aru-pat/C-UAS-Turret/README.md

# C-UAS-Turret

A pan-tilt turret that detects and tracks a drone with a self-trained neural
network and fires a low-power laser lock-on indicator. Semester 1: ground-based
turret detecting and tracking drones; semester 2: mount the system on a drone
platform.

Docs (in `docs/`):
- `project-reqs.md` — what the project must do, hardware split, budget
- `prototype-reqs.md` — checklists for Prototypes 1, 2 and 3
- `gantt.md` — timeline by availability window and key dates
- `design-decisions.md` — every design decision and why I made it
- `s42c-bringup-tests.md` — bench test results and the pin/voltage table for the PCB
- `turret_bom.xlsx` — parts list with links, prices, and decide-by / order-by dates
