aru-pat/C-UAS-Turret/gantt.md

# Timeline — by availability window

| Window | Dates | Load | Work |
|---|---|---|---|
| A | Oct 16 – Nov 2 | Full | Prototype 1 (breadboard motors + hand-detection model + finalize/order custom PCB) |
| B | Nov 2 – Nov 20 | Exams, near-zero | No build work. PCB fab ships passively. |
| C | Nov 20 – Dec 7 | Full (incl. Thanksgiving) | Checkpoint → Prototype 2 → Prototype 3 |
| D | Dec 7 – Dec 11 | Finals, near-zero | Demo video + writeup only. No new builds. |

Split: ~35% effort in A, ~35% in C, ~15% C-tail, ~15% D.

**Checkpoint:** start of Window C. Decide continue vs. simplify based on Prototype 1 results.
