aru-pat/C-UAS-Turret/docs/gantt.md

# Timeline — by availability window

Last updated: Oct 29, 2026

| Window | Dates | Load | Work |
|---|---|---|---|
| A | Oct 16 – Nov 2 | Full | Prototype 1 (breadboard motors + drone-detection model + laser) and design/order the custom PCB |
| B | Nov 2 – Nov 20 | Exams, near-zero | No build work. PCB fab ships passively. Order Pi parts by Nov 10. |
| C | Nov 20 – Dec 7 | Full (incl. Thanksgiving) | Checkpoint → Prototype 2 → Prototype 3 |
| D | Dec 7 – Dec 11 | Finals, near-zero | Demo video + writeup only. No new builds. |

Split: ~35% effort in A, ~35% in C, ~15% C-tail, ~15% D.

**Checkpoint:** start of Window C. Decide continue vs. simplify based on Prototype 1 results.

## Key dates (conservative; the BOM has the per-part version)

| Date | What |
|---|---|
| Sat Oct 17 night / Mon Oct 19 | Order motor kits and USB camera (the ECE shop won't have them). Mon Oct 19: check the ECE shop, then place the Amazon and Digi-Key orders; buy fuse parts locally |
| Oct 20 | Last day to order the cheap AliExpress 5 V module if I want to test it before the PCB order |
| Oct 24 | Decide the 5 V module (and have the power connector settled) so PCB layout can start; CAD target done |
| Oct 26 | Motor checkpoint (the ESP32 fallback date was dropped on Oct 26). Bench tests of the S42C kits passed Oct 25-28; Nucleo driving a motor is still to do. Screws ordered by this date |
| Oct 30 | **Target** PCB fab order + connectors/passives order |
| Nov 1 | **Hard limit** for the PCB order (exams start Nov 2) |
| Nov 10 | Order Pi 5 8 GB, power supply, cooler, microSD |
| Nov 20 | Window C starts: Prototype 2 |
| Nov 22 / 24 | Decide / order the battery, only if building one (must arrive before Dec 1) |
| Nov 23 | Decide the Coral after measuring the Pi alone |
| Dec 7 | Prototype 3 done; Window D (finals) |
| Dec 12 | Demo-ready |
