aru-pat/C-UAS-Turret/docs/turret_bom.xlsx

Sheet: BOM
Counter-UAS Turret - Bill of Materials (one row per part)
Updated 2026-10-19. Status: Verified = I opened the live page and saw this price/stock. Needs check = price seen in a search result or unconfirmed detail. Estimate = my guess, no listing. Blue = typed-in input. Qty 0 = not counted in totals. Shipping and tax NOT included.
ORANGE rows = ECE SHOP LOANS: I must RETURN them (see the Return to ECE Shop tab). PURPLE rows = from my 2k7 lab kit (free, mine). Both cost $0 here.
# | Subsystem | Part name | Specific component | Qty | Prototype | Status | Unit price ($) | Ext. price ($) | Vendor | Link | Est. arrival | Why I chose it | CAD footprint | KiCad footprint | Notes / watch-outs | Decide by | Order by
PROTOTYPE 1 - order now (breadboard motors + trained model + laser)
1 | Control | Microcontroller dev board: NUCLEO-G474RE (OPTIONAL, not counted) | STMicroelectronics NUCLEO-G474RE (Nucleo-64, STM32G474RE) | 0 | P1 | Verified | $20.13 | $0.00 | Digi-Key | Link (https://www.digikey.com/en/products/detail/stmicroelectronics/NUCLEO-G474RE/10231585) | Digi-Key. Shipping time not shown on the page; confirm at checkout. | I wanted the motor brain to be the one the industry or resume people will like better, so STM32 instead of ESP32, with one condition: it must cost only about 5 extra hours, because time is my tightest limit (10-12 hrs/week). We used Arduino-style code (PlatformIO) to hold it to that. The Nucleo-G474RE is a chip plus a built-in USB programmer on one board, so I can start testing motors right away. The G474 was chosen because the G431RB is out of stock with a 99-week lead time. Escape hatch: if no motor is turning by Oct 26, I switch to an ESP32-S3. I also chose to make my custom PCB a carrier board that this Nucleo plugs into, so this board stays in the finished turret. |  |  | Seen in stock (1,981) on digikey.com. Its '99 weeks' is the restock lead time, not your wait. Amazon sellers charge $88-349, do not buy there. Ask the Purdue ECE shop first; if they have a Nucleo board, skip this. 2026-10-19: the ECE shop loaned me a Nucleo-144 (row below), so I can start motor tests now. That board goes back, so if the shop wants it back before Dec 12, I buy this one. Not counted because I already have a Nucleo. | Only if I need my own Nucleo | Only if needed (Digi-Key, 2-3 days)
2 | Control | Nucleo-144 dev board (ECE shop LOAN) | STM32 Nucleo-144 with the STM32F746ZG chip, in its black case (the shop's other board was an F413ZH) | 1 | P1 | Free: ECE shop (RETURN) | $0.00 | $0.00 | ECE shop (RETURN) |  | n/a | The shop only had two Nucleo-144 boards. I picked the F746ZG over the F413ZH because it is faster (216 MHz vs 100 MHz) and more people use it, so there are more tutorials. It is free and I have it today, so I can start the motor tests now instead of waiting for a board to ship. It is a loan, so it goes back to the ECE shop. |  |  | RETURN to the ECE shop. In the code project, pick the STM32F746ZG (not the G474 or the H723; the shop catalog's link for it was wrong). The programming port looks like Micro-B in the photo, which matches the Micro-B cable I got. A Nucleo-144 does not plug into a carrier made for the smaller Nucleo-64, so use jumper wires for P1. | Done Oct 19 | Not buying (loan). Return it to the ECE shop.
3 | Motion | Closed-loop motor + driver kit (pan + tilt) | BIGTREETECH S42C V1.1 + metal cover + motor kit (Octobigtree) | 2 | P1 | Verified | $39.99 | $79.98 | Amazon | Link (https://www.amazon.com/dp/B09LHFS2HF) | Listing showed delivery Sun Oct 18 on your screen. | Closed-loop motors were in the original spec: backlash and lost steps were named as a top failure risk, and a turret has to turn fast to track a moving target without losing its aim. I need motors soon so I can start the CAD, the breadboard wiring and model training, so the pick had to arrive in days. The BTT S42C kit includes the motor, the driver and the position sensor, so there is nothing to match up, costs $39.99 each, and Amazon showed delivery Oct 18. Plain steppers with separate drivers (about $50 for two axes) were rejected as open-loop. I chose 12 V for the motor rail because a 12 V battery is much cheaper than a 24 V one, and my rule was: if it is not that much slower, go 12 V. The 24 V hedge came from my worry that a turret must move fast: the PCB parts are rated for 24 V so I can upgrade later without a new board. |  |  | Motor is included per the listing title ('S42C V1.1 + Metal Protective Cover + Motor'). Listing parameters image (checked Oct 19): motor supply 12-24 V, max current 1650 mA at 12 V, no-load 620 mA at 12 V, Step/Dir input, 14-bit encoder, 2000 rpm max, STM32G031. Two motors can pull about 3.3 A together at max, so set each motor's current near 1 A on the 3 A loan adapter. Power it first at 12 V with about a 1 A current limit. Motor torque is not stated, and the V1.0 manual pinout may differ from V1.1, so read the labels printed on the board. Check the Amazon delivery address is Purdue, not Palo Alto. 30-day free returns if a unit is dead (some reviewers report dead units). | Decided | Sat Oct 17 night or Mon Oct 19 at the latest (ECE will not have these; critical path for the Oct 26 test)
4 | Laser | Laser module (lock-on indicator) | WOWOONE 10-pack 650 nm 5 mW red dot laser modules, 5 V, 6 mm brass body, pre-wired (Amazon B0GSQTBGJM) | 1 | P1 | Verified | $6.69 | $6.69 | Amazon | Link (https://www.amazon.com/dp/B0GSQTBGJM) | Prime, free delivery Wed Oct 21 if ordered Oct 19 (Amazon showed this on the listing). Check the date at checkout. | I want the laser in Prototype 1 because I want to see the result of it firing when the model detects. I first picked a Walmart 4-pack, but it would not arrive in time, so I switched to this Amazon 10-pack ($6.69, arrives Wed Oct 21). I chose 5 mW over 1 mW because a 1 mW dot is barely visible, and the dot has to be seen in the demo. 10 modules means spares while I test the wiring. |  |  | 5 mW = Class 3R. Uses 5 V and about 20 mA, with a resistor built in, so no extra parts. Turn the barrel to focus the dot at the real distance. Best on a white target board in a dim room, 2-5 m away. Never aim at people, pets or shiny surfaces, never look into it. Some units in a pack are dim or poorly focused; test them all. Do not call it Class 2. | Decided | Mon Oct 19 for Wed Oct 21 delivery
5 | Laser | Laser switch (transistor) | Logic-level N-channel MOSFET: IRLU024N from the ECE shop (2 transistors in the bag; one is a small 3-leg TO-92 part, probably a 2N7000 or 2N2222A, so read the print). Backup: the RFD3055LE logic-level MOSFET in the 2k7 kit. | 2 | P1 | Free: ECE shop (RETURN) | $0.00 | $0.00 | ECE shop (RETURN) + 2k7 kit |  | Digi-Key. Shipping time not shown on the page; confirm at checkout. | An STM32 pin is too weak to power the laser by itself, so this small electronic switch lets the pin turn the laser on and off. The ECE shop gave me the part and my 2k7 kit has a second logic-level MOSFET, so I do not need to buy the $1.80 Digi-Key ones. |  |  | Replaces the 2 x $1.80 Digi-Key order. The laser only draws about 40 mA, so any of these parts works. Ask the desk whether the shop wants small parts like this back. | Done Oct 19 | Not buying (free)
6 | Vision | USB camera (final camera) | Arducam 1080p HDR autofocus USB camera module, 78 deg diagonal, metal body (ASIN B0FX47YSJQ) | 1 | P1 | Verified | $19.99 | $19.99 | Amazon | Link (https://www.amazon.com/dp/B0FX47YSJQ) | Page showed free delivery Mon Oct 19 (order within ~8 hours of Oct 17 evening). | My two reasons: (1) I want the model trained on the same camera the turret will actually use, because a different camera changes the picture quality and hurts training; (2) the camera mount in my CAD depends on the camera's exact size, so choosing the final camera now means I do not redo the CAD. I do NOT want to buy the Pi now, and the Pi camera only works on a Pi, so I needed a camera that plugs into both my laptop and the Pi later: a USB camera. I set a $27 ceiling and picked this Arducam for autofocus, a narrower 78-degree view, a 1 m cable in the box and a small metal body I can unscrew from its stand and mount in a printed holder. I accepted a cheaper picture than the $39-65 cameras and may upgrade once I am committed. |  |  | You plan to unscrew it from its stand and mount just the case. When it arrives, check MJPG 1920x1080 at 30 fps is listed (v4l2-ctl --list-formats-ext on Linux, or OBS on your laptop); return it if not. Includes a 1 m USB cable with a JST connector. Only 22 ratings, 4.0 stars (100+ bought last month). The page does not list MJPEG, cable length, size or weight: get the dimensions before finishing the camera mount in CAD. Cheaper picture quality than the $39-65 cameras. Fallbacks: Arducam IMX219 autofocus $38.99 (B09BR1RNSN), ELP IMX362 $64.99 (B0DQNP1MP9). | Decided | Sat Oct 17 night for Mon delivery, or Mon Oct 19 at the latest (does not depend on the ECE shop)
7 | Power | 12 V 5 A wall adapter (BACKUP, not counted) | Facmogu 12 V 5 A, 60 W AC-DC adapter (ASIN B0711Q5B49) | 0 | P1 | Needs check | $11.99 | $0.00 | Amazon | Link (https://www.amazon.com/dp/B0711Q5B49) | Not seen. Check the listing. | I asked whether the turret could run from a simple laptop charger for now and do the battery later, because the battery set was expensive and I cannot spend $300 in one month. A 12 V 5 A wall adapter is the cheap answer: 12 V is the motor voltage I picked, and 5 A (60 W) covers the estimated peak of about 87 W with some margin. The ECE shop may have one for free, so I will check Monday before buying. |  |  | Not counted while I use the shop's Neewer 12 V 3 A loan. Buy this if the shop needs the Neewer back before Dec 12, or if 3 A keeps shutting off. Check the plug is 5.5x2.1 mm before ordering. Check the plug is 5.5x2.1 mm (the title does not say). The ECE shop may have a 12 V supply you can use. | Nov 15 (only if the shop wants the Neewer back before the demo, or 3 A is too small) | Nov 20 at the latest, only if needed (Amazon, 2 days)
8 | Power | 12 V 3 A wall adapter (ECE shop LOAN) | NEEWER NW-120300D2 power supply: 100-240 V AC in, 12 V DC 3.0 A out, barrel plug, UL listed | 1 | P1 | Free: ECE shop (RETURN) | $0.00 | $0.00 | ECE shop (RETURN) |  | n/a | It powers the two motors for P1. 12 V is the motor voltage I picked, and 3 A is enough while I set each motor's current to about 1 A. It is a free loan from the ECE shop, so I do not pay the $11.99 for the 5 A adapter yet. |  |  | RETURN to the ECE shop. The label says output 12 V DC (the AC on the label is the wall side). 3 A is near the limit: two motors can pull about 3.3 A if both stall, so keep each motor's current setting near 1 A. Before connecting: check the plug is 5.5x2.1 mm with the center pin positive (+), and measure about 12 V DC at the plug. The first motor power-up should still use a bench supply set to 12 V with about a 1 A limit, if I can borrow one. | Done Oct 19 | Not buying (loan). Return it to the ECE shop.
9 | Power | Barrel jack to screw terminals | 2.1 x 5.5 mm female DC power jack to screw terminal connector, from the 2k7 kit (kit part ELCONN-DCP.ST-M-03) | 1 | P1 | Free: 2k7 kit | $0.00 | $0.00 | 2k7 kit |  | n/a | Lets me plug the wall adapter in and get two plain wires (+ and -) for the breadboard. My 2k7 lab kit already comes with one, so I do not need the $6.99 Amazon 20-pack. |  |  | Replaces the Amazon 20-pack. Check the loan adapter's plug really is 5.5 x 2.1 mm (it fits this jack if so). | Done Oct 19 | Not buying (free)
10 | Power | Fuse holder | Inline ATC (regular size) blade fuse holder, rated 15 A or more. Reference part: Bussmann #12, Hemlock SKU 580112 | 1 | P1 | Estimate | $5.00 | $5.00 | Auto parts store / ECE shop (Hemlock = fallback) | Link (https://hemlockhardware.com/products/580112-bussmann-20-amp-12-atc-inline-blade-fuse-holder) | Same day at a local store (not checked). Hemlock fallback: in stock, 1-2 day delivery. | I asked what a fuse is and why I need it: it is a cheap part that melts on a short circuit and cuts power before wires get hot, and the holder lets me replace it. I chose to skip the online store (Hemlock) because of its shipping cost and to buy at an auto parts store or get it from the ECE shop. Must be a regular ATC size, rated 15 A or more. |  |  | Skip Hemlock (shipping). Buy at AutoZone/O'Reilly or ask the ECE shop. Must be regular ATC size (not Mini/Micro), 15 A or more, with thick wire. Price is a guess. | Oct 19 (after ECE shop check) | Mon Oct 19 (local store, same day)
11 | Power | Fuse | 15 A regular-size ATC blade fuses, multi-pack. Reference part: Bussmann 4-pack, Hemlock SKU 573597 | 1 | P1 | Estimate | $6.00 | $6.00 | Auto parts store / ECE shop (Hemlock = fallback) | Link (https://hemlockhardware.com/products/573597-bussmann-15-amp-32-volt-atc-blade-automotive-fuse-4-pack) | Same day at a local store (not checked). Hemlock fallback: in stock, 1-2 day delivery. | Same reasoning as the holder: protects the wiring in a short. 15 A is above the estimated 10 A peak so it will not blow during normal motor bursts. I will buy local or from the ECE shop to avoid shipping. |  |  | Buy spares. If it blows, find out why before replacing it. For P1 on the 3 A loan adapter, a 5 A fuse is enough. 15 A is the final-turret value. | Oct 19 (local store) | Mon Oct 19 (local store, same day)
12 | Power | Spike protector (TVS diode) | Littelfuse SMCJ15A, 15 V standoff, DO-214AB | 1 | P1 | Needs check | $0.99 | $0.99 | Digi-Key | Link (https://www.digikey.com/en/products/detail/littelfuse-inc/SMCJ15A/762382) | Digi-Key. Shipping time not shown on the page; confirm at checkout. | Motors switching on and off create brief voltage spikes far above 12 V, and this part clamps them so they cannot hurt the drivers or the chip. It fits my 24 V upgrade hedge (I swap it for a higher-voltage version if I move to 24 V). It costs $0.99. |  |  | Use digikey.com, not the Australian site. Price/stock came from Grok, not confirmed by me (I confirmed the part and its 24.4 V clamp). If you move to 24 V later, swap this for a higher-voltage version. | Decided | Oct 30, in the same Digi-Key order as the PCB parts (a $0.99 part is not worth its own shipping)
13 | Power | Bulk capacitor | 100 uF 35 V electrolytic x2 from the 2k7 kit (kit part ELCAP-AE-35V-100U-05), used as a stand-in for the 1000 uF | 2 | P1 | Free: 2k7 kit | $0.00 | $0.00 | 2k7 kit |  | n/a | A small water tank for electricity that smooths the motors' power gulps. The ECE shop's 1000 uF capacitors are only rated 16 V, which is too low for a 12 V rail that can spike, so I use my kit's 100 uF 35 V ones for P1. |  |  | 100 uF is ten times smaller than my 1000 uF plan, which is fine for P1 on a current-limited supply because the S42C boards have their own capacitors. For the final turret, buy a 1000 uF 35 V capacitor (fallback: https://www.getfpv.com/black-xt60-lipo-pigtail-w-35v-1000uf-capacitor-12awg-3pcs.html, $10.99). Never use the shop's 16 V ones on the motor rail. | Done Oct 19 | Not buying (free)
14 | Wiring | Breadboard + jumper wires (2k7 kit) | EurekaLeap 3220 tie-point solderless breadboard with 4 binding posts + 350-piece 22 AWG jumper wire set (both from the 2k7 kit) | 1 | P1 | Free: 2k7 kit | $0.00 | $0.00 | 2k7 kit |  | n/a | My 2k7 lab kit comes with a big breadboard and a 350-piece jumper wire set, so I do not buy any. |  |  | The binding posts on the board are handy for the 12 V in and ground. | Done Oct 19 | Not buying (free)
15 | Wiring | Resistors (2k7 kit) | Resistor pack, 1/2 W 1%: 5 of most values, 10 each of 1, 100, 1k, 10k, 100k, 1M (includes 220 ohm and 10k ohm) | 1 | P1 | Free: 2k7 kit | $0.00 | $0.00 | 2k7 kit |  | n/a | The MOSFET needs a 220 ohm resistor on its gate and a 10k ohm resistor to hold it off. My kit has both, so I do not need the shop's. |  |  | Kit part RES-120-00100-EH. | Done Oct 19 | Not buying (free)
16 | Wiring | Male pin headers (ECE shop) | Standard single-row male pin header strips (from the shop's drawer 101) | 1 | P1 | Free: ECE shop (RETURN) | $0.00 | $0.00 | ECE shop (RETURN) |  | n/a | For connecting the motor driver boards and jumper wires to the breadboard. |  |  | Small parts. Ask the desk whether they want these back. | Done Oct 19 | Not buying (free)
17 | Wiring | Hand tools (2k7 kit) | Multi-purpose crimp / strip / cut tool (14-24 AWG), pocket 1/8 in screwdriver, banana-plug test leads, clamp | 1 | P1 | Free: 2k7 kit | $0.00 | $0.00 | 2k7 kit |  | n/a | The kit's tool strips and cuts wire, so I do not borrow wire strippers. The small screwdriver fits terminal screws. |  |  | Kit parts ELTOOL-WCS-YTH-5022-01, ELACC-TSCREWDRIVER-C-01, ELCAB-BNTPL-RB-36i-01. | Done Oct 19 | Not buying (free)
18 | Wiring | USB cable: USB-A to Micro-B (ECE shop LOAN) | USB data cable with a USB-A plug on one end and a Micro-B plug on the other (from my photos), black braided | 1 | P1 | Free: ECE shop (RETURN) | $0.00 | $0.00 | ECE shop (RETURN) |  | n/a | The Nucleo's programming port looks like Micro-B. The shop gave me a cable that matches it, so I do not need to buy one. |  |  | RETURN to the ECE shop. Test it: plug it into the Nucleo and my laptop. If the board lights up but the laptop sees nothing new, it is charge-only. It plugs straight into my laptop's USB-A port. | Done Oct 19 | Not buying (free)
19 | Wiring | USB cable: USB-A to USB-C (ECE shop LOAN) | USB cable with a USB-A plug and a USB-C plug, black braided (from my photos) | 1 | P1 | Free: ECE shop (RETURN) | $0.00 | $0.00 | ECE shop (RETURN) |  | n/a | A second cable from the shop. Free, so I keep it as a spare. |  |  | RETURN to the ECE shop. My laptop has both USB-A and USB-C ports, so this is just a spare. | Done Oct 19 | Not buying (free)
20 | Mechanical | Screws, standoffs, fasteners | M3 screw assortment (motor mounts are M3 on NEMA 17) plus whatever your CAD needs | 1 | P1 | Estimate | $15.00 | $15.00 | Amazon / hardware store |  | n/a | I have access to a 3D printer, so I print the pan-tilt frame and the camera holder, and I can only list exact screw sizes after the CAD is done. I do not own screws but can get them. This $15 is a placeholder. |  |  | Allowance only. Finish the CAD, then list exact screw sizes and lengths before buying. You can print the structure yourself. | After the CAD is done (target Oct 24) | By Oct 26 (must arrive before Nov 2)
21 | Test | Multimeter | Borrowed from a lab or a friend | 0 | P1 | Borrowed | $0.00 | $0.00 | n/a |  | n/a | To measure voltage and find shorts before connecting anything expensive. Borrowed. |  |  | Not in my Oct 19 photos, so I still need to borrow one. Bench supply: use a ~1 A current limit for the first motor power-up. The 2k7 kit has banana-plug test leads but no meter.
 |  | PROTOTYPE 1 TOTAL |  |  |  |  |  | $133.65
PCB - target order Oct 30, hard limit Nov 1 (exams start Nov 2; it ships during the dead zone). Parts depend on your design. Prices are estimates.
22 | PCB | DECISION (pinned): power input connector on PCB | Suggested: screw terminal (takes a wall adapter now, a battery later) | 0 | PCB | Open |  |  | n/a |  | n/a | I chose option D on Oct 17: a barrel jack AND an XT60 battery connector footprint, only one connected at a time. The wall adapter plugs into the barrel jack today and cannot go in backwards; a battery drops into the XT60 later with no redesign. A bare screw terminal was rejected because it can be wired backwards and loosen from vibration. The PCB is only ordered once, so the way power enters has to be right the first time. |  |  | Pinned. Discuss after the other open items. Not a purchase. | Oct 24 (so PCB layout can start) | n/a
23 | PCB | PCB fabrication | 5 boards, 2 layers, from JLCPCB or PCBWay (your design) | 1 | PCB | Estimate | $25.00 | $25.00 | JLCPCB / PCBWay |  | Target Oct 30; hard limit Nov 1. | I will not compromise on the custom PCB: it is the hardware half of my resume line. The board is a carrier board that the Nucleo plugs into, which I chose over a bare-chip board to cut risk (no fine-pitch chip soldering, no chip start-up problems) while keeping a real PCB design with real soldering. It must be ordered by Nov 1 at the latest (target Oct 30) so it ships during the exam dead zone. |  |  | Estimate includes shipping. Get a quote when the design is done. | Design finished Oct 30 | Target Oct 30; hard limit Nov 1 (exams start Nov 2)
24 | PCB | Microcontroller chip (OPTIONAL, not counted) | STM32G474 (package chosen in your design), same family as the Nucleo | 0 | PCB | Needs check | $10.70 | $0.00 | Digi-Key | Link (https://www.digikey.com/en/products/result?keywords=STM32G474RET6) | Order Oct 30 with the PCB. | Optional and not counted, my call. The Nucleo stays on the carrier board, so the bare chip is only needed if I later go chip-down. The price was found on a Digi-Key search result. |  |  | Optional for now: the PCB is a carrier board that the Nucleo plugs into, so the chip stays on the Nucleo. Only needed if you later go chip-down (your own chip on your own board). STM32G474RET6 (64-pin LQFP) was $10.70 on a Digi-Key search result; check stock if you do. | Only if going chip-down | Only if going chip-down (with the PCB order, buy 2)
25 | PCB | 5 V module for the Pi - OPTION A (counted) | Pololu D24V50F5, 5 V 5 A step-down regulator (item 2851) | 1 | PCB | Verified | $32.95 | $32.95 | Pololu | Link (https://www.pololu.com/product/2851) | 220 in stock (Oct 17). Order with the PCB. | The Pi needs a steady 5 V at about 5 A. I asked which design was more time-efficient and looked cleaner and more professional, and chose to have the PCB power the Pi, because I need the PCB by Prototype 2/3 anyway. A ready-made module that plugs into a socket means no regulator design. Option A is the known-good one from Pololu. I said to hold the choice for about a week (around Oct 24). |  |  | Known-good option. Needed for the final PCB (Prototype 3). In Prototype 2 the Pi runs on its wall supply instead. Option B below is cheaper but unproven. | Oct 24 (a week out); must be settled before layout | Oct 30, same time as the PCB order
26 | PCB | 5 V module for the Pi - OPTION B (not counted) | Generic 24V/12V to 5V 5A buck module, AliExpress (listing 3256809254781510) | 0 | PCB | Needs check | $5.24 | $0.00 | AliExpress | Link (https://www.aliexpress.us/item/3256809254781510.html) | Ships from China, likely 1-3 weeks (not checked). | A much cheaper alternative I found, kept as a second option. The seller's 5 A claim needs testing with a meter before it ever powers a Pi. I will decide between A and B in about a week. |  |  | The two options for the 5 V part are A (Pololu) and B (this). $5.24 normal price, 4.8 stars from only 58 reviews. The '5 A' claim is doubtful on this type of board; test with a meter and a dummy load before connecting a Pi. Footprint differs from Option A, so pick before the PCB layout is final. | Oct 24 | If you want to TEST it before the PCB order, buy by Oct 20 (ships 1-3 weeks). Ordered later, it arrives after the PCB is already sent.
27 | PCB | Connectors, passives, headers | Screw terminals, female headers for the Nucleo to plug into, resistors, capacitors for the PCB | 1 | PCB | Estimate | $15.00 | $15.00 | ECE shop / Digi-Key |  | Order Oct 30 with the PCB. | The small parts that finish the board. General items like these may be free from the Purdue ECE shop, so much of this may cost nothing. |  |  | Much of this may be free from the ECE shop. My 2k7 kit also has 1N5819 Schottky diodes (a possible reverse-polarity part) and spare resistors. | Oct 30 | Oct 30, same time as the PCB order (Digi-Key, 2-3 days)
 |  | PCB TOTAL |  |  |  |  |  | $72.95
PROTOTYPE 2 - order by Nov 10 (Pi wired to motors, live tracking)
28 | Vision | Raspberry Pi 5 (8 GB) | Raspberry Pi 5 8GB, board only (CanaKit SKU PI5-8GB) | 1 | P2 | Verified | $175.00 | $175.00 | CanaKit | Link (https://www.canakit.com/raspberry-pi-5-8gb.html) | In stock per the page; shipping time not checked. | I chose the 8 GB version and said I did not want the 4 GB: the RAM cannot be upgraded later, and the extra room helps with bigger models and the semester 2 drone work. I decided NOT to buy the Pi now; it is a Prototype 2 purchase, ordered by Nov 10. Training happens on my laptop or Colab, and the Pi only runs the finished model. |  |  | PiShop also lists $175. Adafruit lists $200. The 4 GB is $110 at CanaKit (not chosen). | Nov 6 | By Nov 10 (arrive before Nov 20)
29 | Vision | Pi power supply | RasTech 27 W GaN USB-C PD supply, 5.1 V 5 A for Raspberry Pi 5 (ASIN B0CLV6WB4L) | 1 | P2 | Needs check | $12.34 | $12.34 | Amazon | Link (https://www.amazon.com/dp/B0CLV6WB4L) | Not seen. Check the listing. | In Prototype 2 the Pi runs from its own wall supply so a bug in the brand-new PCB cannot ruin the checkpoint. The Pi wants 5 V at 5 A; a weaker charger can make it crash. |  |  | Official Pi 27 W supply is $22.91 on Amazon if you want the safest option. Check reviews for 5 A output. | Nov 6 | By Nov 10, same CanaKit order
30 | Vision | Pi cooler | Raspberry Pi 5 Active Cooler (CanaKit SKU RSP-ACTIVE-COOLER) | 1 | P2 | Verified | $11.95 | $11.95 | CanaKit | Link (https://www.canakit.com/raspberry-pi-5-active-cooler.html) | In stock per the page. | Running the model makes the Pi hot and a hot Pi slows itself down. A heatsink with a small fan keeps it fast during a demo. A passive heatsink from the ECE shop may do. |  |  | Order with the Pi to save shipping. A passive heatsink from the ECE shop may work if it is cooler where you test. | Nov 6 | By Nov 10, same CanaKit order
31 | Vision | Coral USB Accelerator (optional) | Google Coral USB Accelerator, Edge TPU, model G950-01456-01 (Amazon listing B07S214S5Y) | 0 | P2 | Needs check | $135.00 | $0.00 | Amazon | Link (https://www.amazon.com/dp/B07S214S5Y) | Amazon search result showed delivery Fri Oct 23 (confirm at checkout). | I asked what I lose without it and why I need another chip to run the model. Answer: the Pi 5's own chip probably runs the model fast enough, and a benchmark says the Pi 5 is about on par for this kind of model. I chose to PIN it as optional because it plugs into the Pi over USB, so adding it later changes nothing on the PCB or the wiring. The price swings from $89 to $200 and the Newark listing will not deliver until 2027. I decide at P2 after measuring the Pi alone. |  |  | Qty 0 so it is not counted. Prices for the same product vary by seller ($108.99 to $199.99 on Amazon; this $135.00 listing is the one you picked). Newark lists it at $89.35 (https://www.newark.com/coral/g950-01456-01/usb-accelerator-raspberry-pi/dp/26AJ4884) but says deliveries start 1/10/2027 and the lead time is 41 weeks, so it will not arrive before Dec 12. Evidence that you may not need it: Hackster's benchmark says Pi 5 TFLite performance is roughly on par with the Coral for MobileNet SSD models, and a Pi 4 CPU manages 2-5 fps. | Nov 23 (after measuring the Pi alone) | Nov 23, only if needed (Amazon 2-day; check the price first)
32 | Vision | microSD card | 32 GB or larger microSD card | 1 | P2 | Open |  |  | ECE shop or own |  |  | The Pi boots from this and stores the model. Probably free from the ECE shop or a card I already own. |  |  | Probably free from the ECE shop or a card you already own. | Nov 6 | By Nov 10 (or ECE shop)
 |  | PROTOTYPE 2 TOTAL |  |  |  |  |  | $199.29
OPTIONAL / NOT COUNTED (qty 0): battery set and alternatives. Decide in late November.
33 | Power | Battery charger | Waveshare PSU-12.6V2A-5.5-2.1-US (12.6 V, 2 A) | 0 | P3 | Needs check | $6.99 | $0.00 | Waveshare | Link (https://www.waveshare.com/product/psu-12.6v2a-5.5-2.1-eu.htm) | Not verified. | I decided no battery pack yet. The battery set is optional and not counted; I can add it later once I am committed to the project. Needed only if I build the pack. |  |  | Only needed if you build the battery pack. | Nov 22 | Nov 24, only if building a battery
34 | Power | Power switch + reverse-polarity protection | Pololu Big Pushbutton Power Switch with Reverse Voltage Protection, HP (item #2813) | 0 | P3 | Verified | $8.95 | $0.00 | Pololu | Link (https://www.pololu.com/product/2813) | Pololu ships same day from Las Vegas; confirm at checkout. | Part of the optional battery set I decided to hold off on. A push-button switch that also blocks a backwards battery. |  |  | Not an emergency cutoff. Only needed with the battery. | Nov 22 | Nov 24, only if building a battery
35 | Power | Battery pack | 3S2P 18650 pack with BMS, >= 6 Ah, BMS >= 15 A. Build or buy decided at P3 | 0 | P3 | Open | $42.00 | $0.00 | TBD |  |  | I asked why the battery is so expensive and chose to leave it out for now and run from the wall adapter. Buy-or-build is a late-November decision; the price is an estimate for a DIY pack. |  |  | Price is my estimate for a DIY pack ($40-45). Pre-made packs I found miss the current spec or lack a stated BMS. | Nov 22 | Nov 24, only if building a battery (must arrive before Dec 1)
36 | Motion | ALTERNATIVE: Stepper motor (pan + tilt) | STEPPERONLINE NEMA 17 bipolar stepper, 2 A, 59 Ncm, 48 mm body, 1 m cable (ASIN B00PNEQKC0) | 0 | ALT | Verified | $14.99 | $0.00 | Amazon | Link (https://www.amazon.com/dp/B00PNEQKC0) | Amazon Prime. Listing showed free delivery Sun Oct 18 (confirm at checkout). | Not counted. I went back to closed-loop kits; this open-loop option stays only as a fallback. |  |  | Not counted: we went back to closed-loop kits. Plain (open-loop) stepper: no position sensor. Fine for a light load. Encoder feedback is a stretch goal. | n/a | n/a
37 | Motion | ALTERNATIVE: Stepper driver (pan + tilt) | BIGTREETECH TMC2209 V1.3 stepper driver module, STEP/DIR + UART (ASIN B07ZPV4HFP) | 0 | ALT | Needs check | $9.99 | $0.00 | Amazon | Link (https://www.amazon.com/dp/B07ZPV4HFP) | Amazon Prime. Listing showed free delivery Mon Oct 19 (confirm at checkout). | Not counted. I went back to closed-loop kits; this open-loop option stays only as a fallback. |  |  | Not counted: we went back to closed-loop kits. The title says one module but a bullet mentions '4PCS'. Open the page and check the quantity before ordering. If it is a single, buy 2. Set the current limit to about 1.2-1.5 A. | n/a | n/a
SHIPPING AND TAX ALLOWANCE (counted). Estimate until you check out.
38 | Allowance | Shipping + tax allowance | Digi-Key (~$8-10), CanaKit (~$10-15), Hemlock (~$6), Indiana sales tax on non-Amazon orders, plus a cushion | 1 | SHIP | Estimate | $50.00 | $50.00 | n/a |  | n/a | So the total is closer to what actually leaves my account. I said not to fret too much about the budget because a friend may help fund the build in exchange for a resume credit. |  |  | Amazon Prime items ship free. Replace this number with the real checkout totals as you order. | n/a | n/a
39 | Allowance | China orders + unknowns allowance | AliExpress/Alibaba orders (slow shipping, tax), plus parts you find you need once you start building | 1 | SHIP | Estimate | $30.00 | $30.00 | n/a |  | n/a | I want to budget for orders from China (slow shipping, tax) and for surprises I will only find once I start building. |  |  | A guess. Replace it with real numbers as you go; delete whatever you do not use. | n/a | n/a
 |  | SHIPPING + TAX ALLOWANCE TOTAL |  |  |  |  |  | $80.00
 |  | GRAND TOTAL (all counted rows: P1 + PCB + P2 + shipping/tax) |  |  |  |  |  | $485.89

Sheet: Summary
Budget summary
Budget target ($) | 380 | Your target. Change it here and everything below updates. Shipping and tax are NOT in these numbers.
Prototype 1 (order now) | $133.65 | Closed-loop kits, G474 dev board, laser, camera, fuse, TVS. ECE shop loans and 2k7 kit parts are $0.
PCB (order target Oct 30, hard limit Nov 1) | $72.95 | Estimates; depends on your design.
Prototype 2 (order by Nov 10) | $199.29 | Pi 5 8 GB, power supply, cooler, Camera Module 3, cable.
Shipping + tax allowance (estimate) | $80.00 | Replace with real checkout totals.
Prototype 3 / optional (battery) | $0.00 | Qty 0 right now, so not counted. Coral is also not counted (see Coral row).
TOTAL (counted rows) | $485.89
Remaining vs target | -$105.89 | Negative (red) means over target.
If you add the battery set later (reference) | $57.94 | Charger + switch + pack estimate.
Coral USB Accelerator (optional) | $135.00 | Decide at P2 after measuring the Pi alone.
GRAND TOTAL WITHOUT optional items | $485.89 | Everything you actually need, incl. shipping/tax allowance.
GRAND TOTAL WITH optional items | $678.83 | Adds battery set + Coral.
Counted rows still 'Estimate' or unpriced | 8 | Rows whose price is a guess or missing.
Counted rows marked Verified | 6 | Seen on the live listing.
What the ECE shop and my 2k7 kit covered
- Got free on Oct 19 (return the ECE shop ones): Nucleo-144 F746ZG loan, Neewer 12 V 3 A adapter, 2 USB cables, pin headers, 2 transistors
- From my 2k7 kit: breadboard, jumper wires, resistors, DC jack with screw terminals, 100 uF caps, hand tool
- Replaced Oct 17 items: 12 V 5 A adapter ($11.99, now a backup), barrel jack 20-pack ($6.99), 2 MOSFETs ($3.60)
- Still not free: S42C motor kits, Arducam, laser pack, fuse + holder, TVS, G474 Nucleo, screws, PCB, Pi parts

Sheet: Legend
Status
Verified | I opened the live product page and saw this price and stock.
Needs check | Price came from a search result or a detail is unconfirmed. Check it before buying.
Estimate | My guess. No listing yet.
Owned / Borrowed | Not purchased, not counted.
Qty 0 | Not counted in totals (owned, optional, or an alternative).
Yellow cells | CAD and KiCad footprints, filled in later.
Free: 2k7 kit (purple) | Comes in my ECE 2k7 lab kit. Costs $0 and I keep it.
Free: ECE shop (orange) | Loan from the ECE shop. Costs $0 but I must RETURN it. See the Return to ECE Shop tab.
Safety | The laser is only a lock-on indicator. Never aim it at people, pets or shiny surfaces.

Sheet: Buy Today (Oct 19)
What I still have to BUY - Mon Oct 19, 2026
Everything else for Prototype 1 is free: ECE shop loans (return them) and my 2k7 kit. Prices are from the BOM tab.
BUY TODAY (do not depend on the ECE shop)
Done | Item | Qty | Unit ($) | Ext ($) | Vendor | Link | Notes
☐ | BIGTREETECH S42C closed-loop motor + driver kit (pan + tilt) | 2 | $39.99 | $79.98 | Amazon | Link (https://www.amazon.com/dp/B09LHFS2HF) | Critical path: the Oct 26 motor test needs these. The ECE shop has no motors. The kit includes the motor. 30-day free returns.
☐ | Arducam 1080p autofocus USB camera | 1 | $19.99 | $19.99 | Amazon | Link (https://www.amazon.com/dp/B0FX47YSJQ) | Final camera for training and the turret. When it arrives, check MJPG 1920x1080 at 30 fps is listed (v4l2-ctl or OBS); return it if not.
☐ | WOWOONE 5 mW red laser 10-pack | 1 | $6.69 | $6.69 | Amazon | Link (https://www.amazon.com/dp/B0GSQTBGJM) | Prime, arrives Wed Oct 21. Test every unit; some are dim. Never aim at people, pets or shiny surfaces.
☐ | Inline ATC fuse holder (regular size) | 1 | $5.00 | $5.00 | Local auto parts / hardware store | Link (https://hemlockhardware.com/products/580112-bussmann-20-amp-12-atc-inline-blade-fuse-holder) | Buy at a local auto parts store or hardware store, same day. Price is a guess. Regular ATC size, thick wire.
☐ | ATC blade fuses (5-10 A for P1; 15 A for the final turret) | 1 | $6.00 | $6.00 | Local auto parts / hardware store | Link (https://hemlockhardware.com/products/573597-bussmann-15-amp-32-volt-atc-blade-automotive-fuse-4-pack) | Local store, same day. Buy a multi-pack. Price is a guess.
 | TOTAL TO BUY TODAY |  |  | $117.66
DIGI-KEY - with the Oct 30 PCB-parts order (one order, so shipping is paid once)
Done | Item | Qty | Unit ($) | Ext ($) | Vendor | Link | Notes
☐ | Littelfuse SMCJ15A spike protector (TVS diode) | 1 | $0.99 | $0.99 | Digi-Key | Link (https://www.digikey.com/en/products/detail/littelfuse-inc/SMCJ15A/762382) | A $0.99 part, so it rides in the same Digi-Key order as the PCB parts on Oct 30. The first bench power-up uses a current limit, so it can wait.
 | DIGI-KEY ORDER TOTAL (before shipping) |  |  | $0.99
LATER / ONLY IF NEEDED (not today)
Done | Item | Qty | Unit ($) | Ext ($) | Vendor | Link | Notes
☐ | Screws, standoffs, fasteners (placeholder) | 1 | $15.00 | $15.00 | Amazon / hardware store |  | Order by Oct 26, after the CAD is done. Must arrive before Nov 2.
☐ | STMicroelectronics NUCLEO-G474RE (only if the shop wants its Nucleo back) | 1 | $20.13 | $20.13 | Digi-Key | Link (https://www.digikey.com/en/products/detail/stmicroelectronics/NUCLEO-G474RE/10231585) | Not needed while I have the shop's loan. Only if the shop wants it back before Dec 12.
☐ | 12 V 5 A wall adapter (backup) | 1 | $11.99 | $11.99 | Amazon | Link (https://www.amazon.com/dp/B0711Q5B49) | Only if the shop wants the Neewer back before Dec 12, or 3 A is too small. Check the plug size first.
 | LATER TOTAL (if everything here is needed) |  |  | $47.12
 | Pi 5 parts and the PCB come later: Pi order by Nov 10, PCB order target Oct 30 (hard limit Nov 1). 5 V module choice is parked until about Oct 24.

Sheet: Return to ECE Shop
RETURN THESE TO THE ECE SHOP
Everything on this list is a loan from the Purdue ECE shop. It is not mine. Bring it back when I am done.
Shop questions: eceshop@purdue.edu. Ask the front desk how long the loan lasts and write the date in the last column. The demo is Dec 12.
Returned | Item | Qty | What it is for | Notes | Return by (ask the desk)
☐ | STM32 Nucleo-144 dev board with STM32F746ZG, in its black case | 1 | Motor brain for Prototype 1 (the test setup) | Return the case too. Do not solder to it.
☐ | NEEWER NW-120300D2 12 V 3 A power supply (with AC cord) | 1 | Powers the motors | Has a barrel plug. Return the plug end and the AC cord.
☐ | USB cable, USB-A to Micro-B (black braided) | 1 | Programs the Nucleo from my laptop
☐ | USB cable, USB-A to USB-C (black braided) | 1 | Spare / laptop connection
☐ | Male pin headers (bag of strips) | 1 | Breadboard connections | Small parts: ask the desk whether they want these back.
☐ | Transistors (2 in a static bag: IRLU024N + a small TO-92 part) | 2 | Laser switch | Small parts: ask the desk whether they want these back.
 | NOT a loan: from my 2k7 lab kit (mine, nothing to return)
 | EurekaLeap 3220 breadboard with binding posts
 | 350-piece 22 AWG jumper wire set
 | Resistor pack (220 ohm, 10k ohm and more)
 | 2.1 x 5.5 mm DC jack with screw terminals
 | 100 uF 35 V capacitors (x2) and RFD3055LE logic-level MOSFET
 | Multi-purpose strip/crimp tool, pocket screwdriver, banana test leads
