aru-pat/C-UAS-Turret/pcb/C-UAS-Turret.kicad_pcb

## KiCad design pcb/C-UAS-Turret.kicad_pcb (2026-11-13)

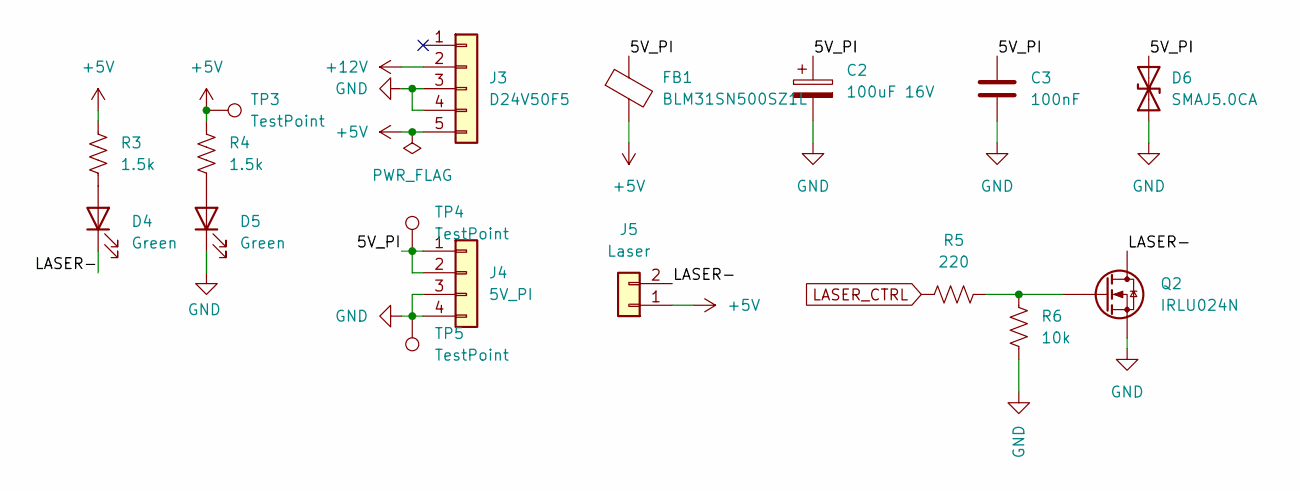
[picture p1: schematic 5v_laser.kicad_sch, 5V Laser]

Parts:
C2: 100uF 16V; CP_Radial_D5.0mm_P2.00mm
C3: 100nF; C_0805_2012Metric
D4, D5: Green; LED_0805_2012Metric
D6: SMAJ5.0CA; D_SMA
FB1: BLM31SN500SZ1L; L_1206_3216Metric
J3: D24V50F5; PinHeader_1x05_P2.54mm_Vertical
J4: 5V_PI; JST_XH_B4B-XH-A_1x04_P2.50mm_Vertical
J5: Laser; JST_XH_B2B-XH-A_1x02_P2.50mm_Vertical
Q2: IRLU024N
R3, R4: 1.5k; R_0805_2012Metric
R5: 220; R_0805_2012Metric
R6: 10k; R_0805_2012Metric
TP3, TP4, TP5: TestPoint; TestPoint_THTPad_D2.0mm_Drill1.0mm

Connections:
+5V: FB1.2, J3.5, J5.1, R3.1, R4.1, TP3.1 (1_1)
+12V: J3.2; also elsewhere on the board
/5V and Laser/5V_PI: C2.1, C3.1, D6.2 (A2), FB1.1, J4.1, J4.2, TP4.1 (1_1)
/5V and Laser/LASER-: D4.1 (K), J5.2, Q2.D
GND: C2.2, C3.2, D5.1 (K), D6.1 (A1), J3.3, J3.4, J4.3, J4.4, Q2.S, R6.2, TP5.1 (1_1); also elsewhere on the board
LASER_CTRL: R5.1; also elsewhere on the board
unnamed: D4.2 (A), R3.2
unnamed: D5.2 (A), R4.2
unnamed: Q2.G, R5.2, R6.1

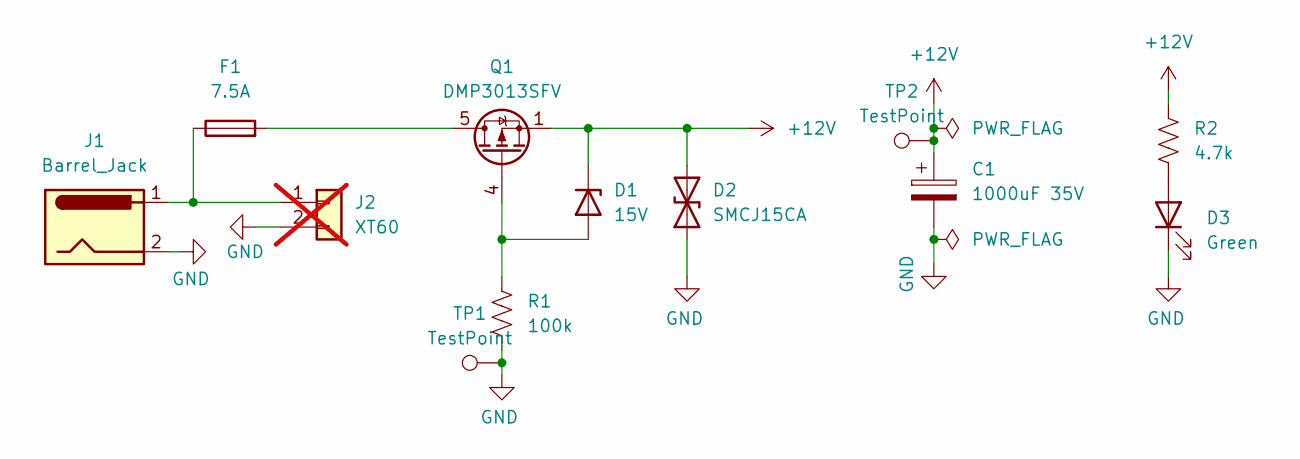
[picture p2: schematic power_input.kicad_sch, Power Input: 12 V Entry and Protection]

Parts:
C1: 1000uF 35V; CP_Radial_D12.5mm_P5.00mm
D1: 15V; D_SOD-123
D2: SMCJ15CA; D_SMC
D3: Green; LED_0805_2012Metric
F1: 7.5A; FuseHolder_Blade_ATO_Littelfuse_FLR_178.6165
J1: Barrel_Jack; BarrelJack_CUI_PJ-063AH_Horizontal
J2: XT60; AMASS_XT60PW-M_1x02_P7.20mm_Horizontal; not fitted
Q1: DMP3013SFV; Diodes_PowerDI3333-8
R1: 100k; R_0805_2012Metric
R2: 4.7k; R_0805_2012Metric
TP1, TP2: TestPoint; TestPoint_THTPad_D2.0mm_Drill1.0mm

Connections:
+12V: C1.1, D1.1 (K), D2.2 (A2), Q1.1 (S), Q1.2 (S), Q1.3 (S), R2.1, TP2.1 (1_1); also elsewhere on the board
GND: C1.2, D2.1 (A1), D3.1 (K), J1.2, J2.2, R1.2, TP1.1 (1_1); also elsewhere on the board
unnamed: D1.2 (A), Q1.4 (G), R1.1
unnamed: D3.2 (A), R2.2
unnamed: F1.1, J1.1, J2.1
unnamed: F1.2, Q1.5 (D)

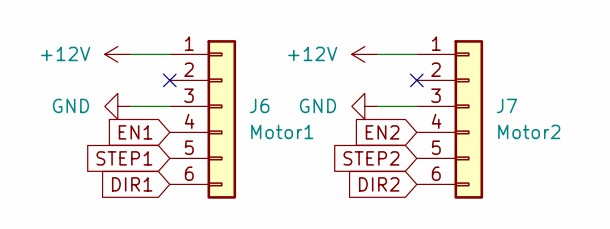
[picture p3: schematic motors.kicad_sch]

Parts:
J6: Motor1; JST_XH_B6B-XH-A_1x06_P2.50mm_Vertical
J7: Motor2; JST_XH_B6B-XH-A_1x06_P2.50mm_Vertical

Connections:
+12V: J6.1, J7.1; also elsewhere on the board
DIR1: J6.6; also elsewhere on the board
DIR2: J7.6; also elsewhere on the board
EN1: J6.4; also elsewhere on the board
EN2: J7.4; also elsewhere on the board
GND: J6.3, J7.3; also elsewhere on the board
STEP1: J6.5; also elsewhere on the board
STEP2: J7.5; also elsewhere on the board

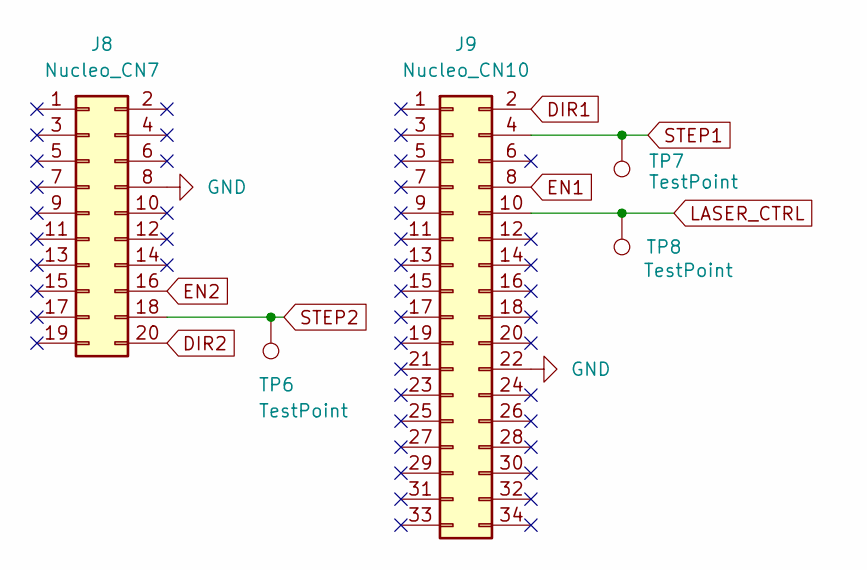
[picture p4: schematic nucleo.kicad_sch]

Parts:
J8: Nucleo_CN7; PPPC102LFBN-RC_NucleoZio_2x10
J9: Nucleo_CN10; PPPC172LFBN-RC_NucleoZio_2x17
TP6, TP7, TP8: TestPoint; TestPoint_THTPad_D2.0mm_Drill1.0mm

Connections:
DIR1: J9.2; also elsewhere on the board
DIR2: J8.20; also elsewhere on the board
EN1: J9.8; also elsewhere on the board
EN2: J8.16; also elsewhere on the board
GND: J8.8, J9.22; also elsewhere on the board
LASER_CTRL: J9.10, TP8.1 (1_1); also elsewhere on the board
STEP1: J9.4, TP7.1 (1_1); also elsewhere on the board
STEP2: J8.18, TP6.1 (1_1); also elsewhere on the board

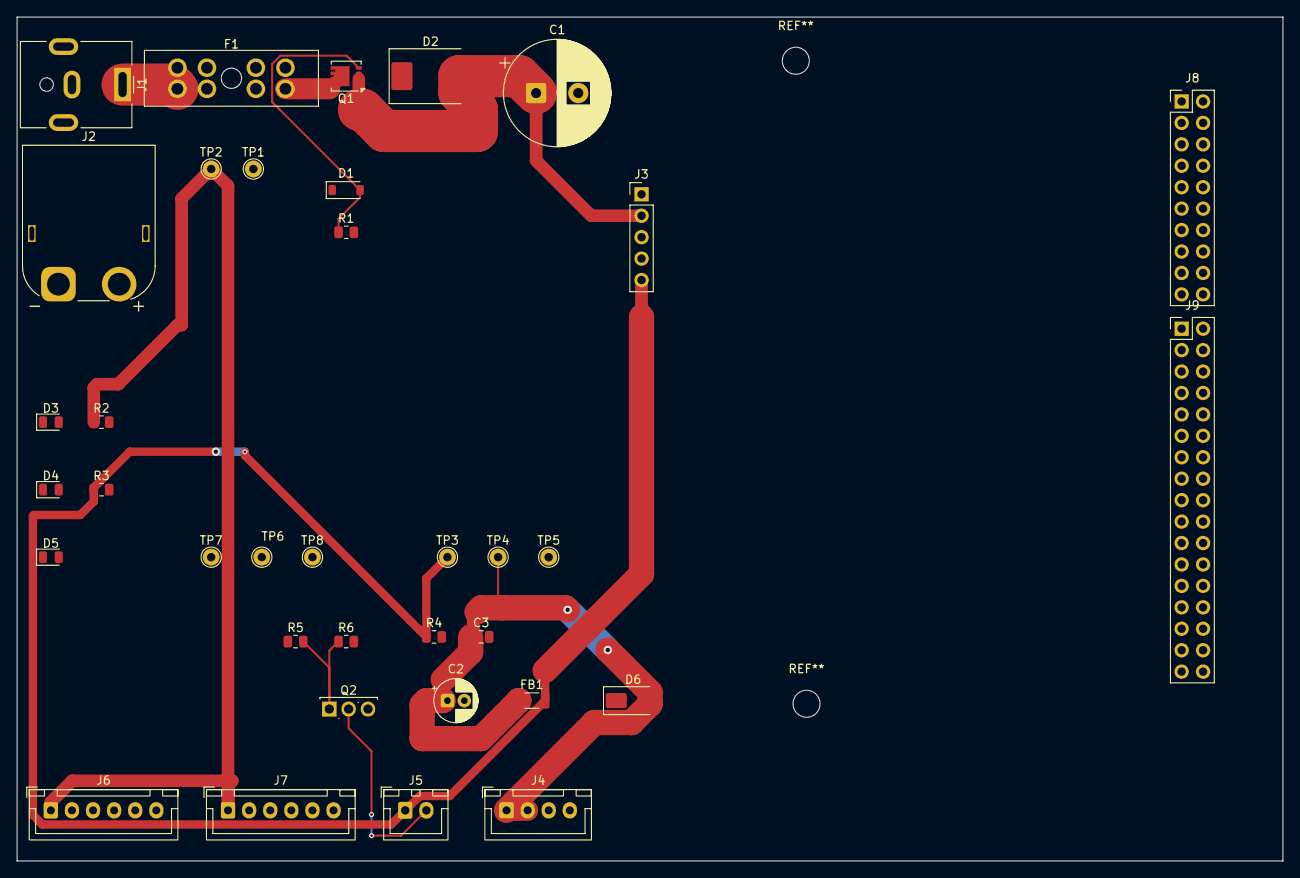
[picture p5: board C-UAS-Turret.kicad_pcb from above]

Board: 2 copper layers, 150.0 x 100.0 mm, 36 parts (0 on the bottom side), 19 nets.
