aru-pat/C-UAS-Turret/(commit log)

2026-10-17 Add gantt chart, project reqs, and prototype reqs docs
    Claude-Session: https://claude.ai/code/session_01TWtjBY2yWbJhxKJJiZSdqh
2026-10-17 Doc: add 24V hedge and laser-in-P1 decision
    Claude-Session: https://claude.ai/code/session_01456Cj7NjpAyM7Q3YBMcz3g
2026-10-17 Doc: lock 8GB Pi 5, pin Coral
    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
2026-10-17 Doc: update design decisions (G474, S42C kits, power connector, USB camera, laser, ordering)
    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
2026-10-17 Doc: remove laser safety note from Decision 10
    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
2026-10-17 Doc: custom PCB is a Nucleo carrier board; bare chip optional
    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
2026-10-17 Doc: move carrier-board rationale under Decision 1
    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
2026-10-17 Add BOM spreadsheet (P1 / PCB / P2, decide-by and order-by dates)
    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
2026-10-17 Make BOM decide-by / order-by dates conservative; update doc dates
    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
2026-10-20 BOM: mark ECE shop loans and 2k7 kit parts as free, add Buy Today and Return to ECE Shop tabs
    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
2026-10-20 BOM: show local store as vendor for fuse rows on Buy Today tab
    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
2026-10-20 BOM: drop G474 Nucleo from counted cost (using the ECE shop Nucleo loan)
    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
2026-10-20 BOM: add S42C listing parameters (12-24 V, 1.65 A) to motor kit note
    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
2026-10-20 BOM: switch laser to WOWOONE 5 mW 10-pack (Amazon, arrives Oct 21)
    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
2026-10-23 BOM: mark Oct 19 Amazon order as received, use real fuse holder and fuse kit listings
    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
2026-10-24 docs: pivot Semester 1 target from hand to drone
    The hand was only ever a stand-in for the real target. We have a hangar
    of drones we can image and fly, so we can collect our own in-domain drone
    data on the Arducam and train directly on the real target.
    - project-reqs: Goal now 'detects a drone'
    - prototype-reqs: P1 vision half collects drone footage (staged by
    range/condition, filmed in clips with per-clip condition logs); P1 laser
    fires on drone detection; P3 detector line matches the YOLO fine-tune
    decision (drops the stale 'not pretrained' wording)
    - gantt: Window A says drone-detection model
    - design-decisions + README: target is a drone throughout
2026-10-24 vision: scaffold the drone-detection pipeline (Stage 1)
    End-to-end pipeline for the vision half, built around two ideas: the model is
    a swappable box, and data discipline is enforced by the tooling.
    Pipeline: capture (verify Arducam MJPG 1080p30 + record clips with a condition
    log) -> extract_frames (sample frames, tag each with its clip_id) -> label
    (external tool, YOLO format) -> split (CLIP-AWARE, no train/test leakage) ->
    dataset (build YOLO dataset.yaml) -> train (fine-tune small YOLO) -> evaluate
    (mAP/precision/recall on held-out test + save failures) -> live_detect (live
    feed, confidence readout, stubbed+gated serial laser-fire signal).
    - configs/drone.yaml: single source of setting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
2026-10-30 docs: add S42C bring-up results, PCB power and Nucleo decisions
    - add docs/s42c-bringup-tests.md with measured pin map and PCB pin table
    - design-decisions: single 12 V input with buck, protection set, linear
    regulator reasoning, Nucleo plug-in with header/wire option, F746ZG loan
    - update prototype-reqs, project-reqs, gantt, README to match
    Claude-Session: https://claude.ai/code/session_01D8nRNadLhzvXdMh7t4n64k
2026-10-30 docs: add PCB block diagram and parts directory, update power and Pi link decisions
    Barrel jack main input with empty XT60 pads, Pi-to-Nucleo link now one USB
    cable (power + serial), reverse guard kept, chip-down PCB dropped, Amazon
    sealed USB-C 5 V module ruled out.
    Claude-Session: https://claude.ai/code/session_01D8nRNYZg9ZYfhvbNH6hDYX
2026-10-30 docs: note BINZET wire-lead 5 V module as a backup option
    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
2026-11-10 Add confirmed parts doc (plug pitch, fuses, Nucleo model flag)
    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
2026-11-11 Add PCB calculations and Nov 10-11 schematic decisions
    Claude-Session: https://claude.ai/code/session_01D8nRNXQ1CfyuALqYgyYVSG
2026-11-11 Add PCB schematic: 4 pages, ERC clean
2026-11-11 Add PCB parts selection, custom footprints and 3D models
    docs/parts-selection.md: one row per part with MPN, distributor stock and
    price readings, footprint, datasheet check and backup; Pololu pin order;
    Nucleo socket and standoff positions; Needs Aru list and morning steps.
    pcb/lib/cuas.pretty: G/D/S-padded TO-252 (SUD50P04-08) and TO-251
    (IRLU024N) footprints for Device:Q_PMOS/Q_NMOS, and X-mirrored 2x10/2x17
    Zio sockets for a face-up NUCLEO-144. 3D models from KiCad packages3D.
2026-11-13 Assign all footprints,Q1 to DMP3013SFV
2026-11-13 parts-selection: red status LEDs, Amazon 12 V 8 A adapter
    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
2026-11-13 Layout: placement + power routing, DRC clean
